gmaxdragon/Jjk-Alarm-Clock-Blare/Docs/COMPACT_REVISION.md

# Compact revision change record

The user authorized retaining the original and rearranging a new smaller version.

- Original: 125 × 110 mm, six switches in a horizontal row.
- Current: 95 × 95 mm, two rows of three full-size switches.
- Top row: SW1 UP, SW3 TIME SET, SW5 SNOOZE.
- Bottom row: SW2 DOWN, SW4 CLOCK SET, SW6 ALARM ON.
- Same electrical schematic, GPIO allocation, component values and logical switch matrix.
- Components moved and tracks rerouted; no uniform scaling. 0.25 mm signal tracks, 0.50 mm power tracks, four 0.7/0.3 mm routing vias, filled bottom GND zone.
- Matching new carrier, front panel and display holder. The normal kit keycaps replace the tall custom extensions in this revision only.
- Decorative source preserved; revised body remeshed on a 1 mm grid before adding functional geometry. Small decorative features can differ.
- The STEP is genuine faceted BREP and the individual print meshes are checked separately. Electronics are reference envelopes.
- New routing, CAD repair/mounts and documentation were produced with substantial AI assistance, disclosed in the README.

The archive includes unchanged original PCB, schematic, project, Gerbers, available original CAD and previous README. `Archive/Original_125x110/PRESERVATION_SHA256.json` records exact source hashes. The original images remain unchanged in Docs/Images.
