gmaxdragon/Jjk-Alarm-Clock-Blare/Docs/REVIEW_REQUEST.md

# JJK Alarm: review request

**Draft only. This message has not been sent and no submission form has been completed.**

Hi,

I'm Vivaan, and this is my JJK Alarm project for BLARE:
https://github.com/gmaxdragon/Jjk-Alarm-Clock-Blare

The original board was too big, so I changed it later with AI's help. The current PCB is 95 x 95 mm, with the six buttons in two rows of three. I kept the original 125 x 110 mm version so you can see the changes.

My friend and I worked on the original PCB and schematic, and I did the original Tinkercad modifications using a MakerWorld shrine model. AI helped with explanations, firmware, the smaller PCB layout and routing, CAD repair and mounting parts, and organizing the files. The README includes my full disclosure and my voice-typed project story.

The current repository has the matching KiCad source files and Gerbers, a complete placed STEP assembly, separate case-part print files, firmware, screenshots, a BOM and validation reports. The electrical checks and firmware compilation pass. The geometry checks use reference component dimensions; I am not claiming the clock has already been printed, assembled, or tested overnight.

I also forgot to click Publish to Stardance for some PCB/schematic timelapses. I selected Public, so I am not sure they were attached. I have not claimed unverified recording hours.

The exact original MakerWorld model link, creator/license and artwork source still need to be recorded in the credits. Please let me know about any required changes and whether the disclosed AI assistance is acceptable for submission. I understand if you return it. Thank you for reviewing it.

Vivaan

## Current file map

- `README.md`: personal story, images, current BOM and disclosures.
- `PCB/`: current 95 mm project, schematic and routed board.
- `Firmware/JJK_Alarm/`: Arduino source and supplied hand-sign image.
- `CAD/JJK_Alarm_Assembly.step`: complete placed assembly, with 50 reimported valid solids and labelled reference electronics.
- `Production/gerbers.zip`: current complete copper/mask/silkscreen/outline/drill package.
- `Production/Case_Parts/`: shrine body, front panel and display retainer.
- `Archive/Original_125x110/`: preserved original design and exports.
- `Docs/SUBMISSION_CHECK.md`: checks and their scope.

Use the current BLARE submission route confirmed by the organizers. This draft does not assert eligibility or acceptance.
