gmaxdragon/Jjk-Alarm-Clock-Blare/Docs/ATTRIBUTION.md

# Source and assistance attribution

- Project owner and original narrated README: Vivaan Goel.
- PCB/schematic hands-on work: Vivaan and a friend, with AI guidance and troubleshooting, as disclosed by the owner.
- Case modifications: Vivaan in Tinkercad. The original shrine geometry includes third-party MakerWorld models.
- MakerWorld model URL, creator, and license: **not supplied in the available project records**. Do not invent a credit or apply a blanket license to that model. Record the exact source and follow its terms before redistribution/submission.
- Screen hand-sign artwork: image supplied by the owner. Its original artist/source and reuse terms have not been established. It is not claimed as original artwork by the project owner.
- Screenshots: original user-uploaded image bytes, recorded in `Images/manifest.json`. No synthetic project views have been substituted.
- `Images/Reference/`: Hack Club kit photo, parts list, and tutorial PCB screenshot supplied by the user; these are reference material, not the user's own PCB.
- Firmware: substantially AI-assisted, using Arduino-ESP32 and Adafruit graphics/display libraries. Library licenses continue to apply to their respective code.
- README editing: dictated by the owner; AI organized/formatted it and corrected technical descriptions. The disclosure is retained, not hidden.
