gmaxdragon/Jjk-Alarm-Clock-Blare/Production/ReviewOnly/READ_FIRST_NOT_APPROVED.md

# BLARE rectangular PCB Gerber preview

**NOT APPROVED FOR FABRICATION.**

Source: PCB/jjkspeakerpcb.kicad_pcb and matching .kicad_sch in this branch.
Generated by KiCad 10 from the rectangular 125 x 110 mm user CAD.
The archive gerbers.zip contains the copper, solder mask, silkscreen, edge cuts,
and plated/non-plated Excellon drill layers.

Native ERC/DRC reports must pass, but physical verification remains outstanding:
TFT module pin order, buzzer 7.6 mm pin pitch/electrical type, XIAO sockets
USB-C/antenna, M3 fasteners, assembly solder quality, power and thermal tests.

Do not order until a human has checked the Gerber preview at the manufacturer.
