gmaxdragon/Jjk-Alarm-Clock-Blare/Archive/README.md

# Historical files

These are superseded T-shaped-design sources and earlier rectangular working exports. They are retained for history, not for fabrication or current dimensions. Use the root PCB, Firmware, CAD and Production folders.
