gmaxdragon/Jjk-Alarm-Clock-Blare/Docs/Images/Compact/PCB_Back.png

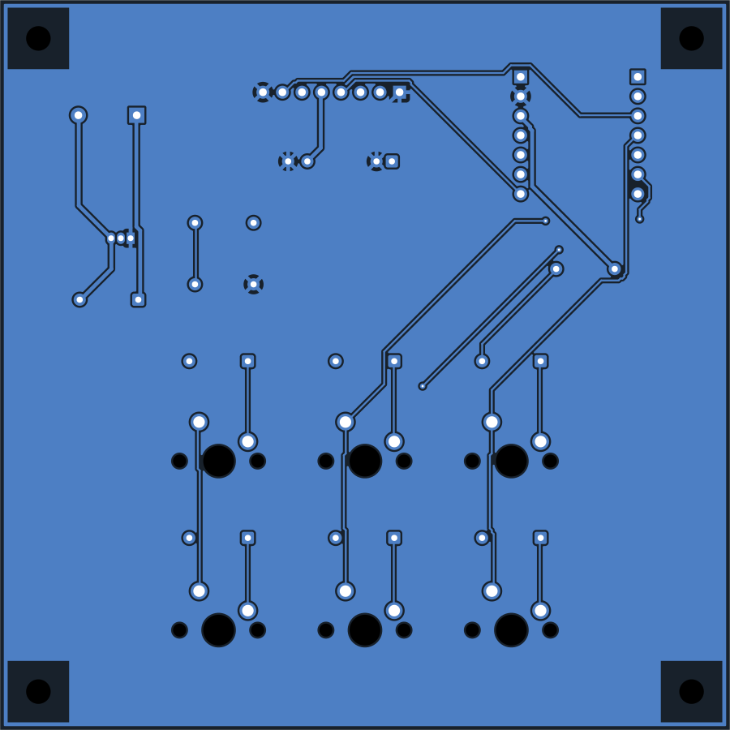
Docs/Images/Compact/PCB_Back.png
