gmaxdragon/Jjk-Alarm-Clock-Blare/Docs/Images/Compact/PCB_Front.png

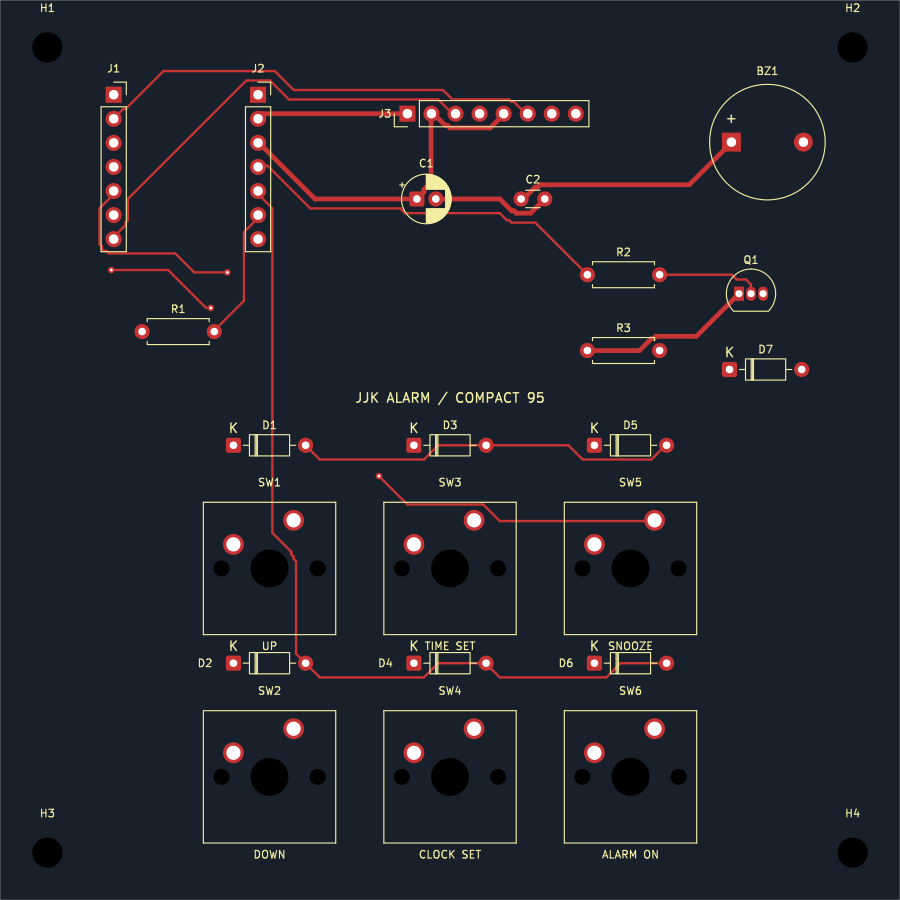
Docs/Images/Compact/PCB_Front.png
