gmaxdragon/Jjk-Alarm-Clock-Blare/Docs/Images/History/Schematic_2026-10-26.png

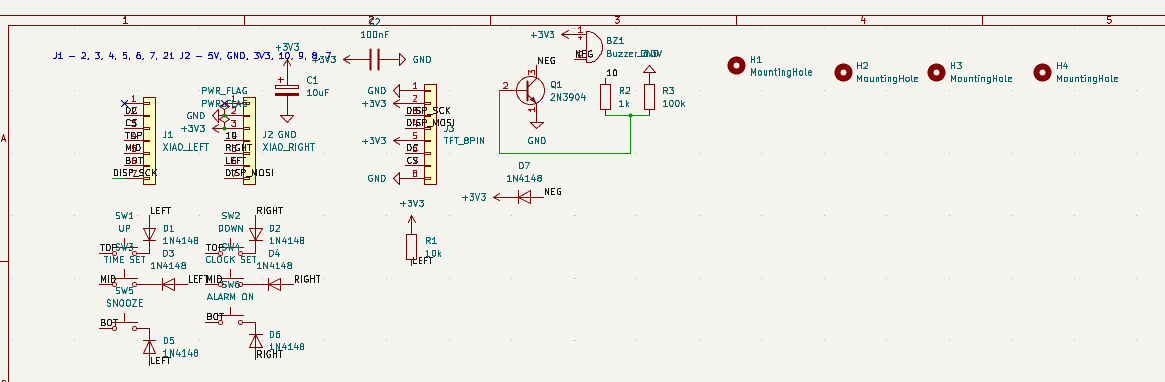
Docs/Images/History/Schematic_2026-10-26.png
