gmaxdragon/Jjk-Alarm-Clock-Blare/Docs/Images/History/Schematic_Earlier.png

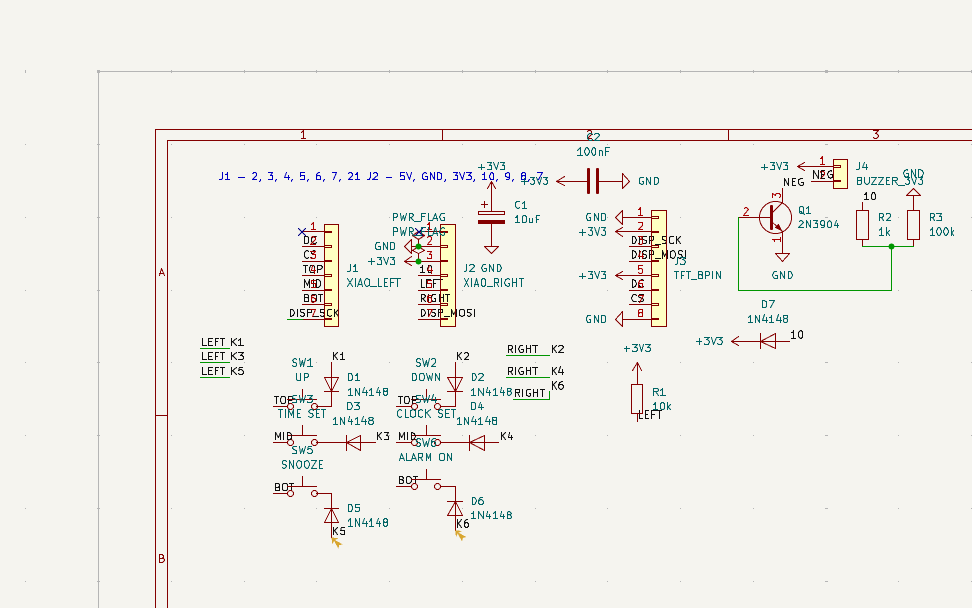
Docs/Images/History/Schematic_Earlier.png
