gmaxdragon/Jjk-Alarm-Clock-Blare/Docs/Images/Reference/BLARE_Example_PCB.png

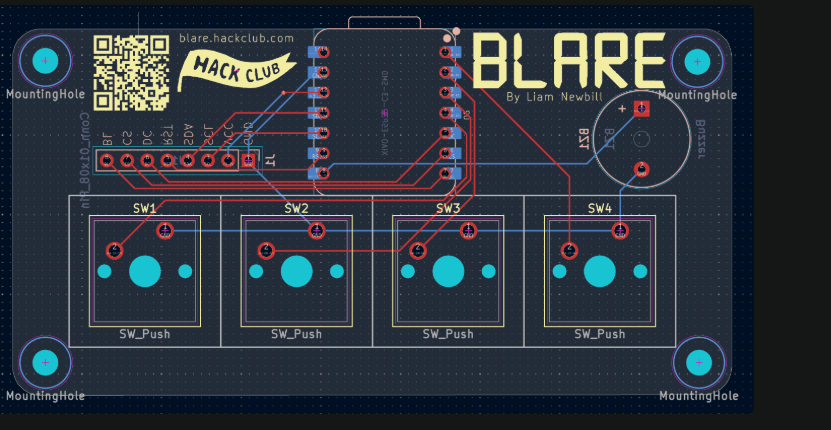
Docs/Images/Reference/BLARE_Example_PCB.png
