gmaxdragon/Jjk-Alarm-Clock-Blare/Docs/Images/Reference/BLARE_Kit.png

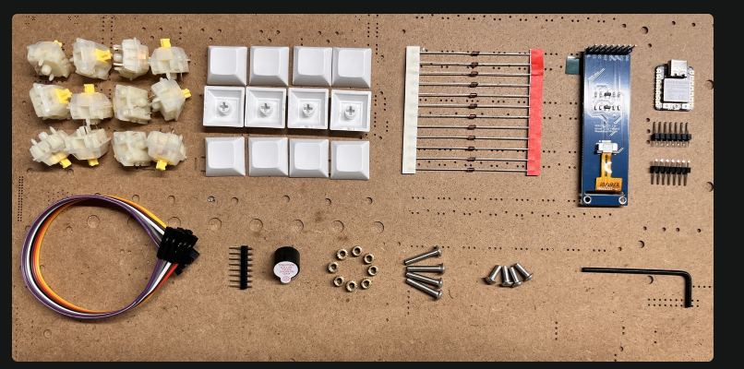
Docs/Images/Reference/BLARE_Kit.png
