gmaxdragon/Jjk-Alarm-Clock-Blare/CAD/Current_References/Component_Positions_mm.csv

Reference | Footprint | X_from_left_mm | Y_from_top_mm | Rotation_deg
BZ1 | Buzzer_12x9.5RM7.6 | 102.475 | 38.775000000000006 | 0.0
C1 | CP_Radial_D5.0mm_P2.00mm | 95.0 | 20.0 | 0.0
C2 | C_Disc_D3.0mm_W1.6mm_P2.50mm | 110.0 | 20.0 | 0.0
D1 | D_DO-35_SOD27_P7.62mm_Horizontal | 19.0 | 59.0 | 0.0
D2 | D_DO-35_SOD27_P7.62mm_Horizontal | 35.0 | 59.0 | 0.0
D3 | D_DO-35_SOD27_P7.62mm_Horizontal | 19.0 | 71.0 | 0.0
D4 | D_DO-35_SOD27_P7.62mm_Horizontal | 35.0 | 71.0 | 0.0
D5 | D_DO-35_SOD27_P7.62mm_Horizontal | 95.0 | 70.0 | 0.0
D6 | D_DO-35_SOD27_P7.62mm_Horizontal | 106.44 | 71.75 | 0.0
D7 | D_DO-35_SOD27_P7.62mm_Horizontal | 99.94 | 61.0 | 0.0
H1 | MountingHole_3.2mm_M3 | 5.0 | 5.0 | 0.0
H2 | MountingHole_3.2mm_M3 | 120.0 | 5.0 | 0.0
H3 | MountingHole_3.2mm_M3 | 5.0 | 65.0 | 0.0
H4 | MountingHole_3.2mm_M3 | 120.0 | 65.0 | 0.0
J1 | PinSocket_1x07_P2.54mm_Vertical | 24.0 | 8.0 | 0.0
J2 | PinSocket_1x07_P2.54mm_Vertical | 39.239999999999995 | 8.0 | 0.0
J3 | PinHeader_1x08_P2.54mm_Vertical | 53.61 | 75.0 | 90.0
Q1 | TO-92_Inline | 97.0 | 51.0 | 0.0
R1 | R_Axial_DIN0207_L6.3mm_D2.5mm_P7.62mm_Horizontal | 30.0 | 42.0 | 0.0
R2 | R_Axial_DIN0207_L6.3mm_D2.5mm_P7.62mm_Horizontal | 82.0 | 46.0 | 0.0
R3 | R_Axial_DIN0207_L6.3mm_D2.5mm_P7.62mm_Horizontal | 83.0 | 59.0 | 0.0
SW1 | SW_Cherry_MX_1.00u_PCB | 17.415000000000006 | 85.91999999999999 | 0.0
SW2 | SW_Cherry_MX_1.00u_PCB | 36.465 | 85.91999999999999 | 0.0
SW3 | SW_Cherry_MX_1.00u_PCB | 55.515 | 85.91999999999999 | 0.0
SW4 | SW_Cherry_MX_1.00u_PCB | 74.565 | 85.91999999999999 | 0.0
SW5 | SW_Cherry_MX_1.00u_PCB | 93.61500000000001 | 85.91999999999999 | 0.0
SW6 | SW_Cherry_MX_1.00u_PCB | 112.66499999999999 | 85.91999999999999 | 0.0
