gmaxdragon/Jjk-Alarm-Clock-Blare/Docs/Images/Reference/BLARE_Parts_List.png

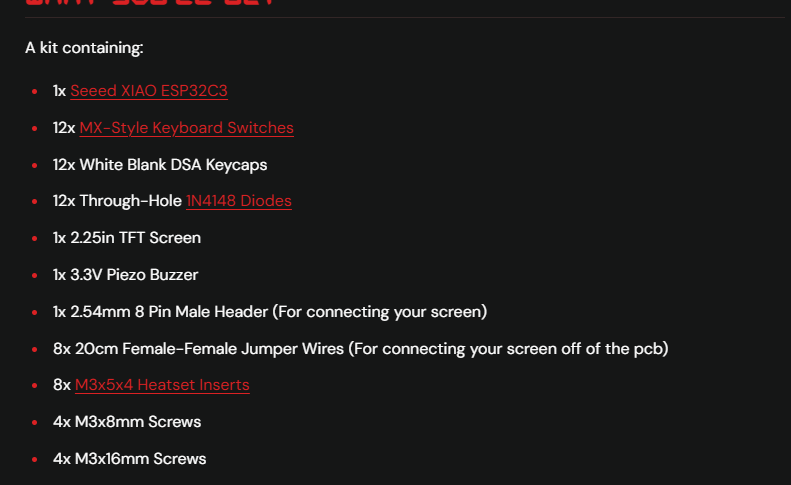
Docs/Images/Reference/BLARE_Parts_List.png
