gmaxdragon/Jjk-Alarm-Clock-Blare/CAD/Current_References/PCB_Finished_Size_Envelope.step

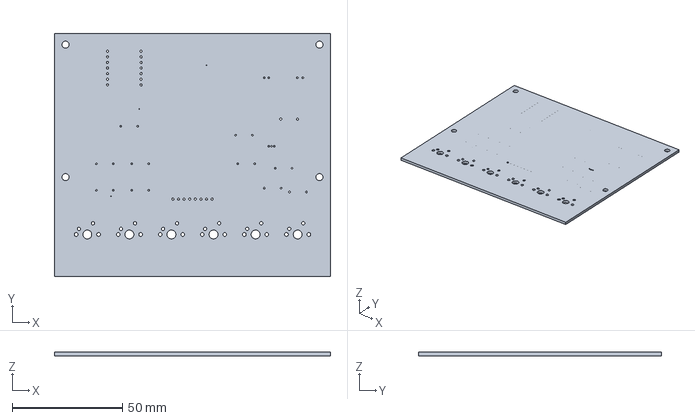
[picture p18: CAD file, 2026-10-28]
CAD/Current_References/PCB_Finished_Size_Envelope.step
125.0 x 110.0 x 1.60 mm
