gmaxdragon/Jjk-Alarm-Clock-Blare/CAD/Owner_Originals/JJK_Alarm_Clock_Enclosure.stl

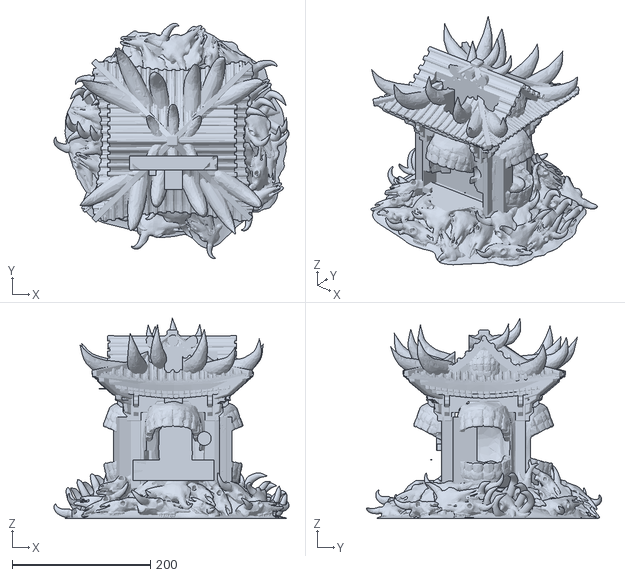
[picture p19: CAD file, 2026-10-28]
CAD/Owner_Originals/JJK_Alarm_Clock_Enclosure.stl
340.0 x 340.0 x 289.8
