gmaxdragon/Jjk-Alarm-Clock-Blare/CAD/Recovered/Keycaps_Recovered.step

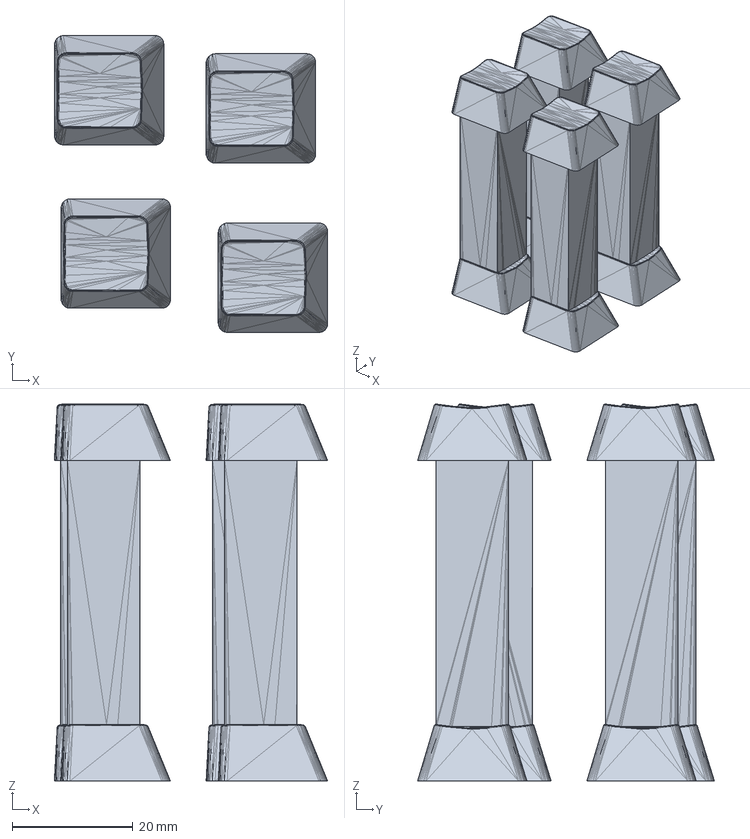
[picture p20: CAD file, 2026-10-28]
CAD/Recovered/Keycaps_Recovered.step
45.2 x 49.1 x 62.4 mm
