gmaxdragon/Jjk-Alarm-Clock-Blare/CAD/Recovered/Original_Keycap_STL/Extended_Keycap_02.stl

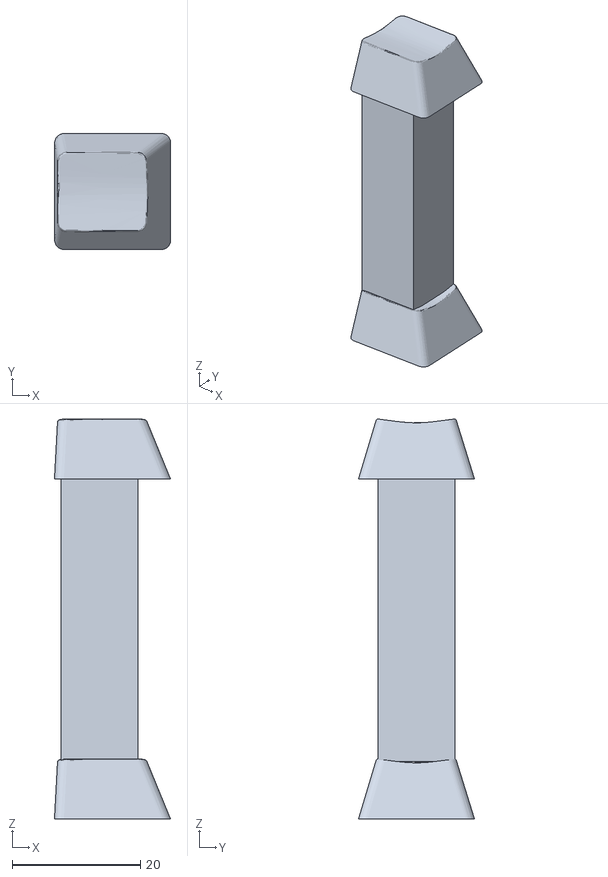
[picture p21: CAD file, 2026-10-28]
CAD/Recovered/Original_Keycap_STL/Extended_Keycap_02.stl
18.1 x 18.1 x 62.4
