gmaxdragon/Jjk-Alarm-Clock-Blare/CAD/Reference/PCB_Finished_Envelope.step

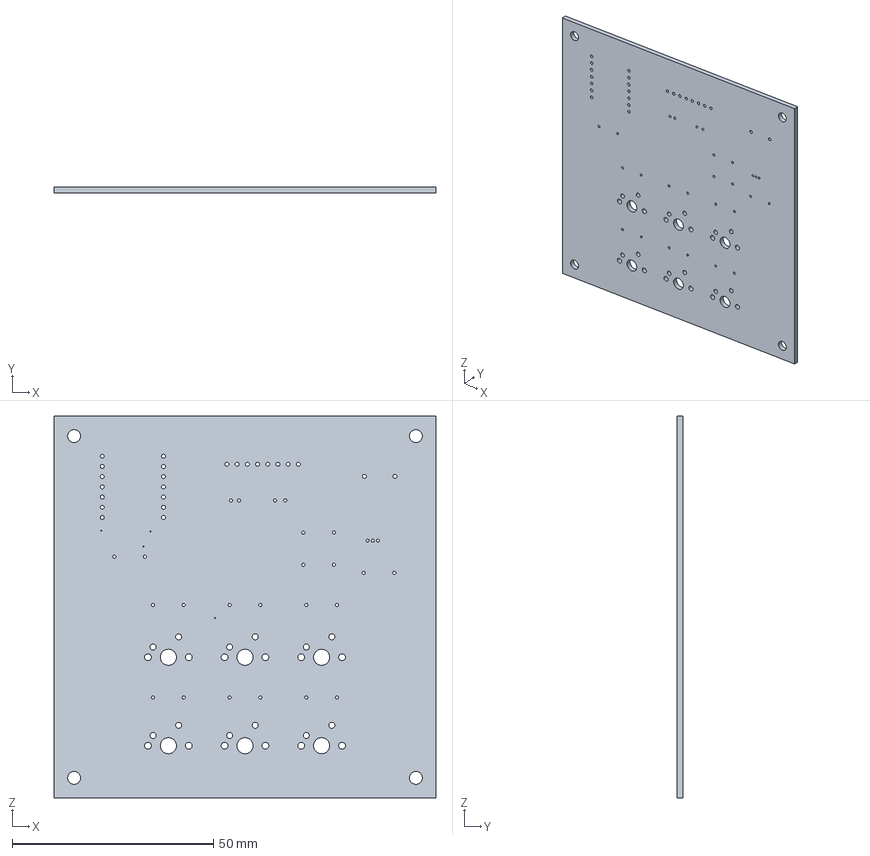
[picture p22: CAD file, 2026-10-28]
CAD/Reference/PCB_Finished_Envelope.step
95.0 x 1.60 x 95.0 mm
