gmaxdragon/Jjk-Alarm-Clock-Blare/Production/Case_Parts/Shrine_Body.stl

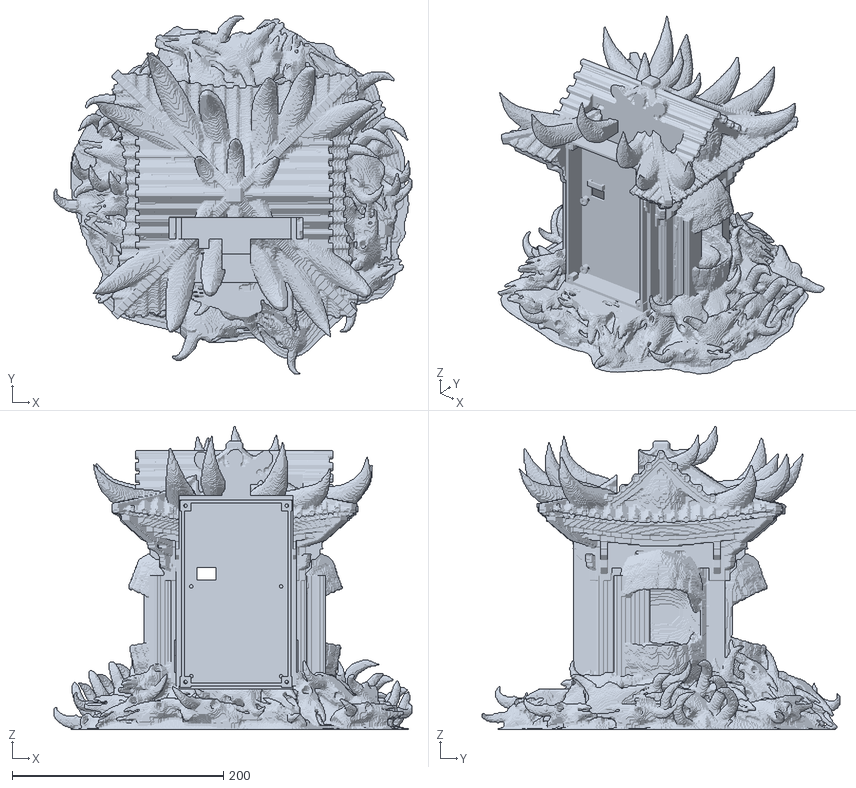
[picture p23: CAD file, 2026-10-28]
Production/Case_Parts/Shrine_Body.stl
339.0 x 339.0 x 287.0
