gmaxdragon/Jjk-Alarm-Clock-Blare/CAD/Current_References/Six_Keycaps.step

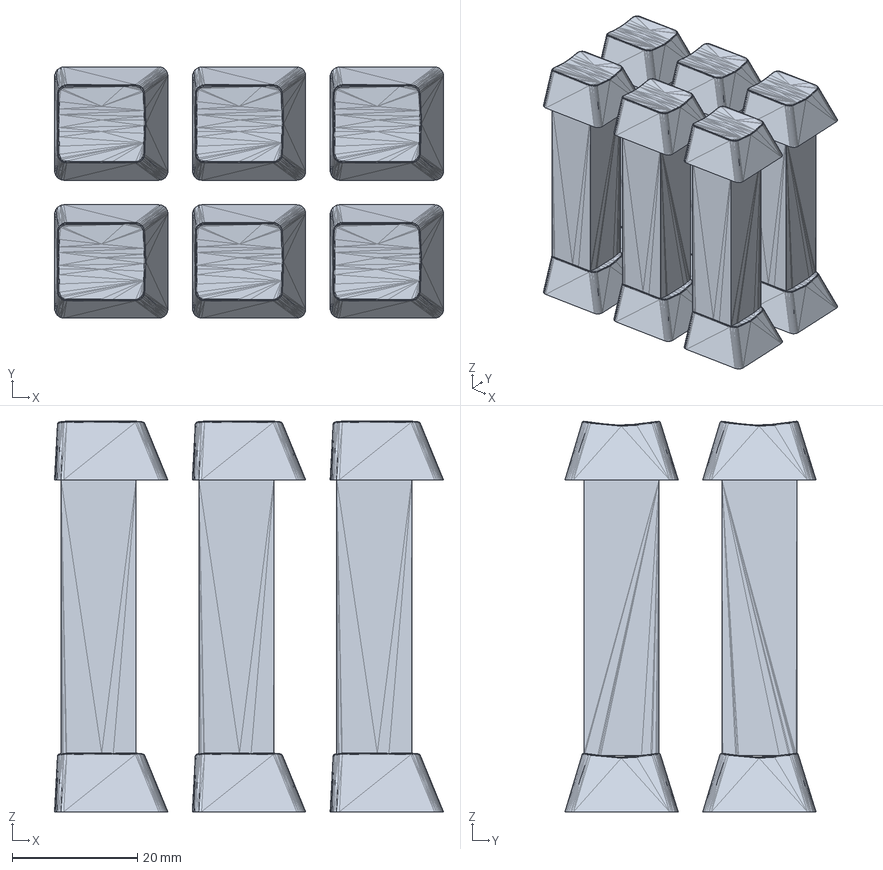
[picture p24: CAD file, 2026-10-28]
CAD/Current_References/Six_Keycaps.step
62.1 x 40.1 x 62.4 mm
