gmaxdragon/Jjk-Alarm-Clock-Blare/CAD/Reference/PCB_Substrate.step

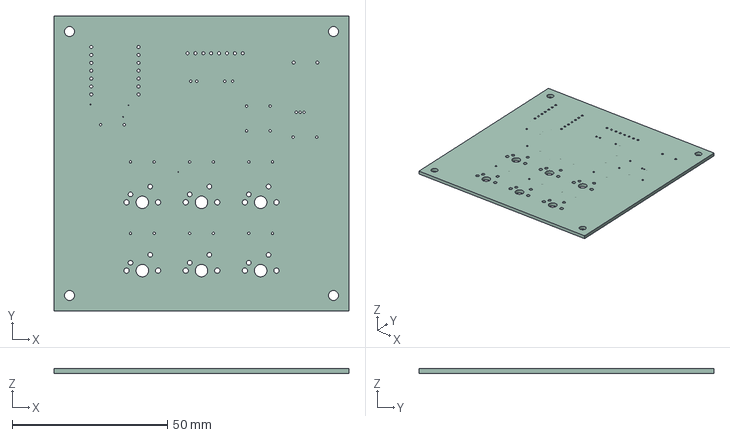
[picture p25: CAD file, 2026-10-28]
CAD/Reference/PCB_Substrate.step
95.0 x 95.0 x 1.51 mm
