gmaxdragon/Jjk-Alarm-Clock-Blare/Production/Case_Parts/Front_Panel.step

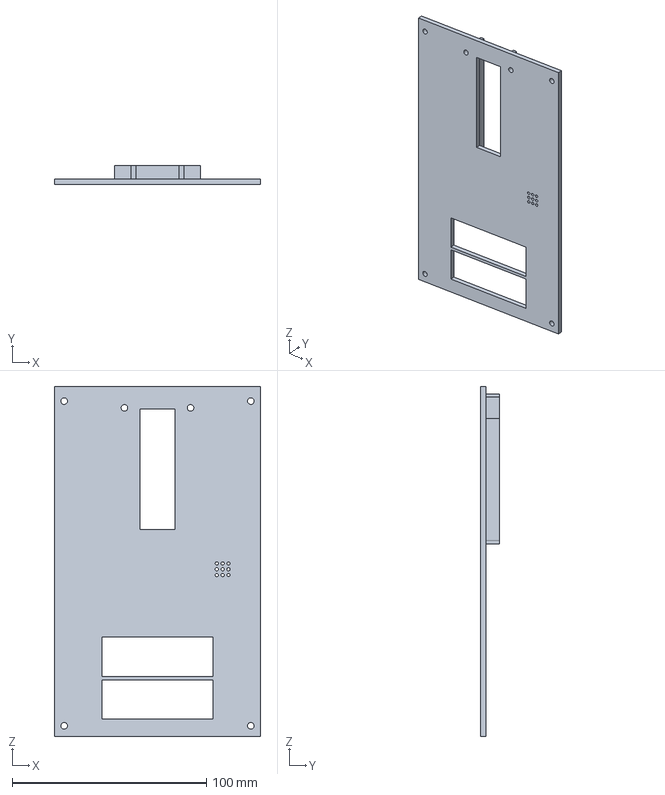
[picture p26: CAD file, 2026-10-28]
Production/Case_Parts/Front_Panel.step
106.0 x 10.0 x 180.0 mm
