gmaxdragon/Jjk-Alarm-Clock-Blare/CAD/Current_References/PCB_Drilled_Body.step

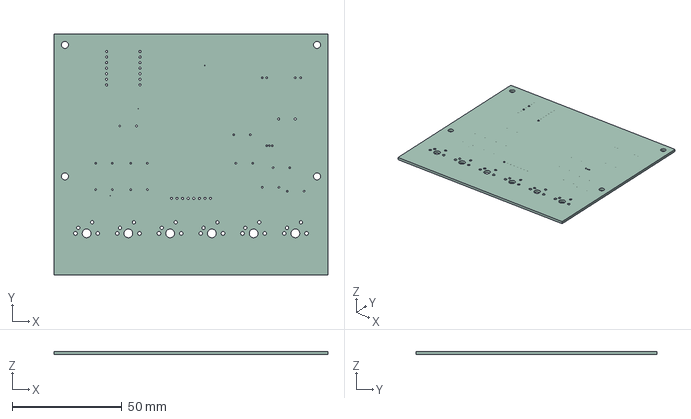
[picture p27: CAD file, 2026-10-28]
CAD/Current_References/PCB_Drilled_Body.step
125.0 x 110.0 x 1.51 mm
