gmaxdragon/Jjk-Alarm-Clock-Blare/Production/Case_Parts/Display_Retainer.step

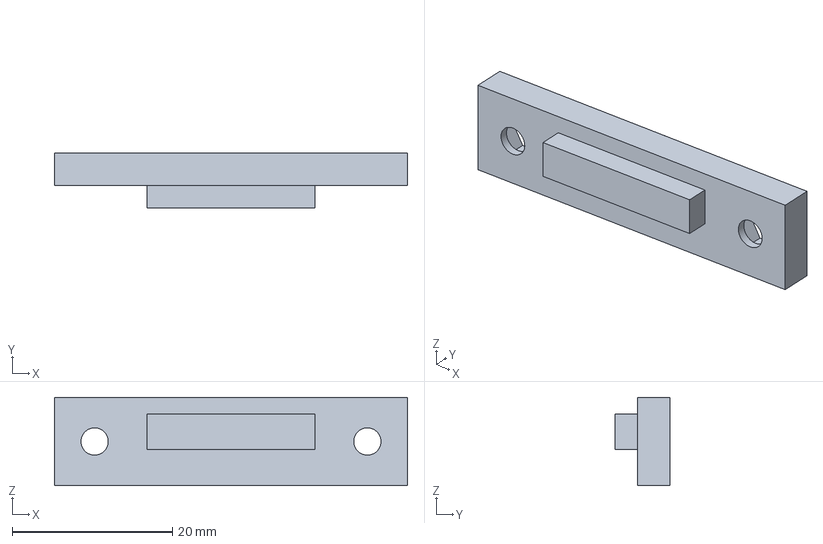
[picture p28: CAD file, 2026-10-28]
Production/Case_Parts/Display_Retainer.step
44.0 x 6.80 x 11.0 mm
