gmaxdragon/Jjk-Alarm-Clock-Blare/(list of files, cad)

Other CAD files:
CAD/JJK_Alarm_Assembly.step
CAD/Recovered/Enclosure_REFERENCE_ONLY.stl
CAD/Recovered/Original_Keycap_STL/Extended_Keycap_03.stl
CAD/Recovered/Original_Keycap_STL/Extended_Keycap_04.stl
CAD/Recovered/Original_Keycap_STL/Extended_Keycap_01.stl
Production/Case_Parts/Keycap_03.step
Production/Case_Parts/Keycap_04.step
Production/Case_Parts/Keycap_06.step
Production/Case_Parts/Keycap_01.step
Production/Case_Parts/Keycap_02.step
Production/Case_Parts/Keycap_05.step
Archive/Original_125x110/CAD/Current_References/PCB_Finished_Size_Envelope.stl
Archive/Original_125x110/CAD/Recovered/Enclosure_REFERENCE_ONLY.stl
Archive/Original_125x110/CAD/Recovered/Original_Keycap_STL/Extended_Keycap_01.stl
Archive/Original_125x110/CAD/Recovered/Original_Keycap_STL/Extended_Keycap_03.stl
Archive/Original_125x110/CAD/Recovered/Original_Keycap_STL/Extended_Keycap_04.stl
Archive/Original_125x110/Production/Case_Parts/Keycap_01.step
Archive/Original_125x110/Production/Case_Parts/Keycap_01.stl
Archive/Original_125x110/Production/Case_Parts/Keycap_02.step
Archive/Original_125x110/Production/Case_Parts/Keycap_02.stl
Archive/Original_125x110/Production/Case_Parts/Keycap_03.step
Archive/Original_125x110/Production/Case_Parts/Keycap_03.stl
Archive/Original_125x110/Production/Case_Parts/Keycap_04.step
Archive/Original_125x110/Production/Case_Parts/Keycap_04.stl
Archive/Original_125x110/Production/Case_Parts/Keycap_05.step
Archive/Original_125x110/Production/Case_Parts/Keycap_05.stl
Archive/Original_125x110/Production/Case_Parts/Keycap_06.step
Archive/Original_125x110/Production/Case_Parts/Keycap_06.stl
CAD/Current_References/PCB_Finished_Size_Envelope.stl
Production/Case_Parts/Display_Retainer.stl
Production/Case_Parts/Front_Panel.stl
Production/Case_Parts/Keycap_01.stl
Production/Case_Parts/Keycap_02.stl
Production/Case_Parts/Keycap_03.stl
Production/Case_Parts/Keycap_04.stl
Production/Case_Parts/Keycap_05.stl
Production/Case_Parts/Keycap_06.stl
