gmaxdragon/Jjk-Alarm-Clock-Blare/Production/Checks/Timer_Tests.txt

JJK timer and stopwatch rollover/pause tests PASS
