gmaxdragon/Jjk-Alarm-Clock-Blare/Production/Checks/Alarm_Tests.txt

JJK AlarmLogic: all 32 behavioral assertions PASS
