gmaxdragon/Jjk-Alarm-Clock-Blare/Docs/Images/History/PCB_2026-10-26.png

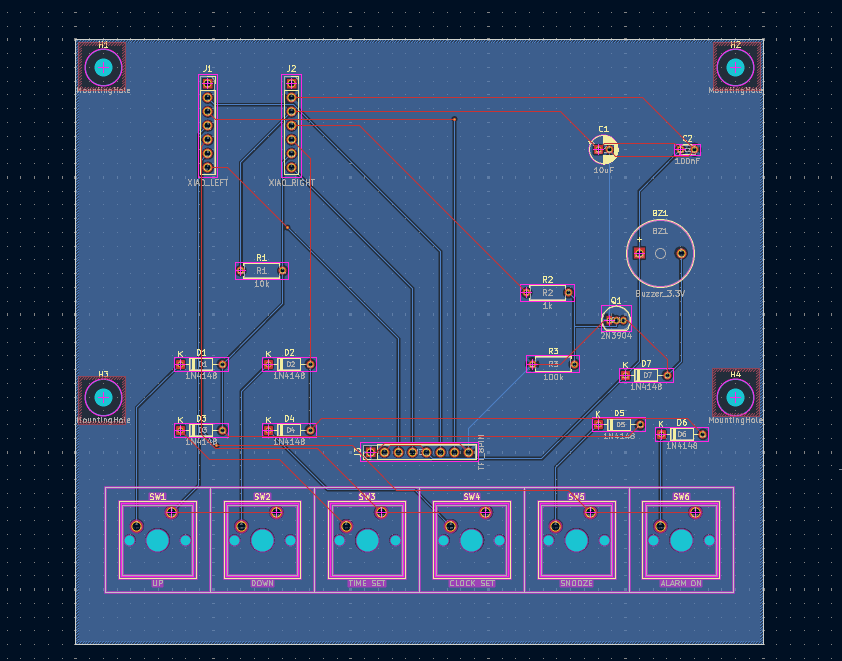
Docs/Images/History/PCB_2026-10-26.png
