gmaxdragon/Jjk-Alarm-Clock-Blare/Docs/Images/History/PCB_Earlier.png

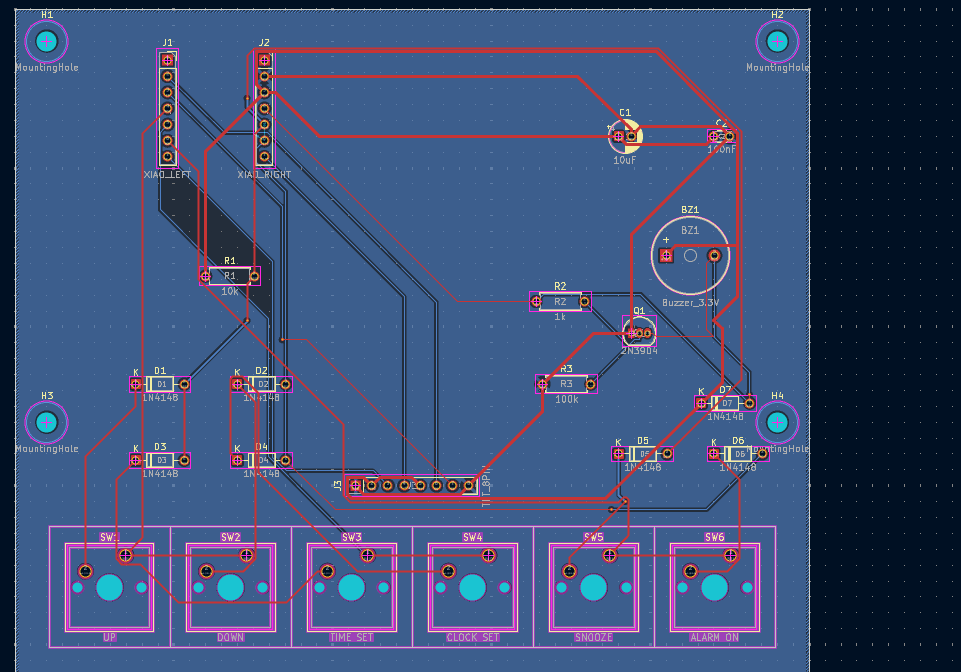
Docs/Images/History/PCB_Earlier.png
