gmaxdragon/Jjk-Alarm-Clock-Blare/Revisions/Compact_95/PCB/jjkspeakerpcb.kicad_pcb

## KiCad design Revisions/Compact_95/PCB/jjkspeakerpcb.kicad_pcb (2026-10-28)

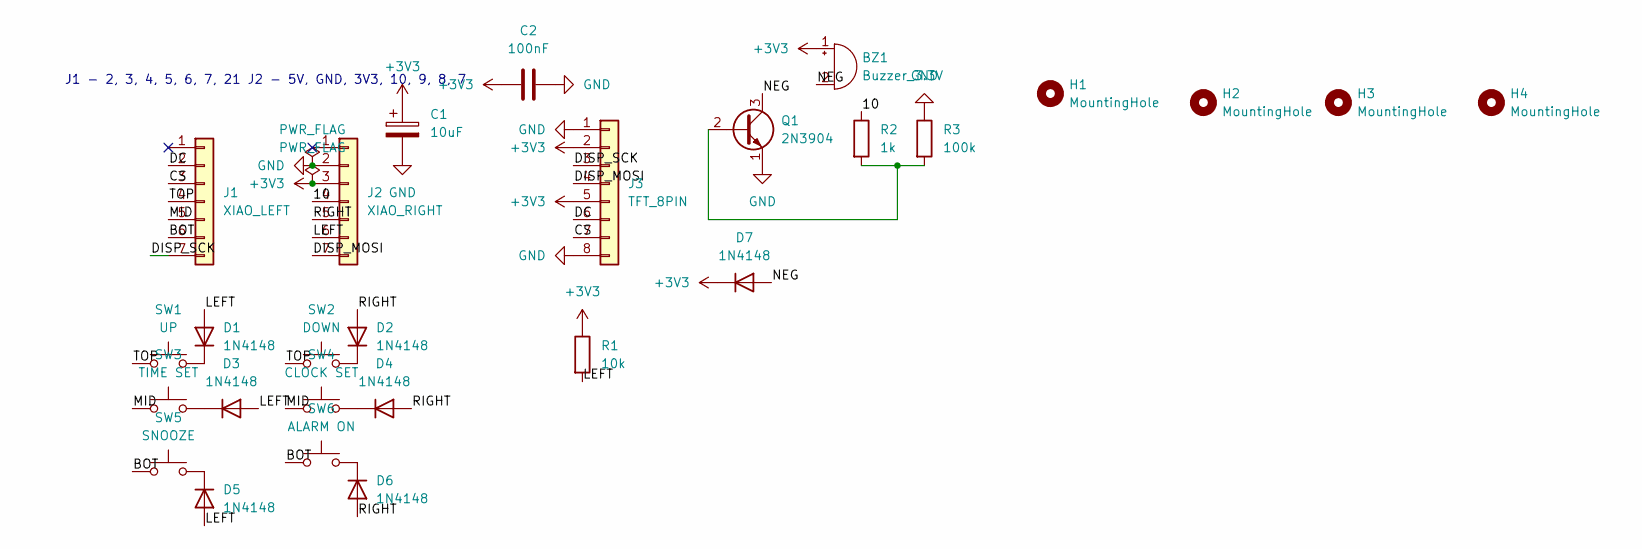
[picture p31: schematic jjkspeakerpcb.kicad_sch]

Parts:
BZ1: Buzzer_3.3V; Buzzer_12x9.5RM7.6
C1: 10uF; CP_Radial_D5.0mm_P2.00mm
C2: 100nF; C_Disc_D3.0mm_W1.6mm_P2.50mm
D1, D2, D3, D4, D5, D6, D7: 1N4148; D_DO-35_SOD27_P7.62mm_Horizontal
H1, H2, H3, H4: MountingHole; MountingHole_3.2mm_M3
J1: XIAO_LEFT; PinSocket_1x07_P2.54mm_Vertical
J2: XIAO_RIGHT; PinSocket_1x07_P2.54mm_Vertical
J3: TFT_8PIN; PinHeader_1x08_P2.54mm_Vertical
Q1: 2N3904; TO-92_Inline
R1: 10k; R_Axial_DIN0207_L6.3mm_D2.5mm_P7.62mm_Horizontal
R2: 1k; R_Axial_DIN0207_L6.3mm_D2.5mm_P7.62mm_Horizontal
R3: 100k; R_Axial_DIN0207_L6.3mm_D2.5mm_P7.62mm_Horizontal
SW1: UP; SW_Cherry_MX_1.00u_PCB
SW2: DOWN; SW_Cherry_MX_1.00u_PCB
SW3: TIME SET; SW_Cherry_MX_1.00u_PCB
SW4: CLOCK SET; SW_Cherry_MX_1.00u_PCB
SW5: SNOOZE; SW_Cherry_MX_1.00u_PCB
SW6: ALARM ON; SW_Cherry_MX_1.00u_PCB

Connections:
+3V3: BZ1.1 (+), C1.1, C2.1, D7.1 (K), J2.3, J3.2, J3.5, R1.1
/10: J2.4, R2.1
/BOT: J1.6, SW5.1, SW6.1
/CS: J1.3, J3.7
/DC: J1.2, J3.6
/DISP_MOSI: J2.7, J3.4
/DISP_SCK: J1.7, J3.3
/LEFT: D1.2 (A), D3.2 (A), D5.2 (A), J2.6, R1.2
/MID: J1.5, SW3.1, SW4.1
/NEG: BZ1.2 (-), D7.2 (A), Q1.3 (C)
/RIGHT: D2.2 (A), D4.2 (A), D6.2 (A), J2.5
/TOP: J1.4, SW1.1, SW2.1
GND: C1.2, C2.2, J2.2, J3.1, J3.8, Q1.1 (E), R3.1
unnamed: D1.1 (K), SW1.2
unnamed: D2.1 (K), SW2.2
unnamed: D3.1 (K), SW3.2
unnamed: D4.1 (K), SW4.2
unnamed: D5.1 (K), SW5.2
unnamed: D6.1 (K), SW6.2
unnamed: Q1.2 (B), R2.2, R3.2

Notes on the sheet:
J1 - 2, 3, 4, 5, 6, 7, 21 J2 - 5V, GND, 3V3, 10, 9, 8, 7

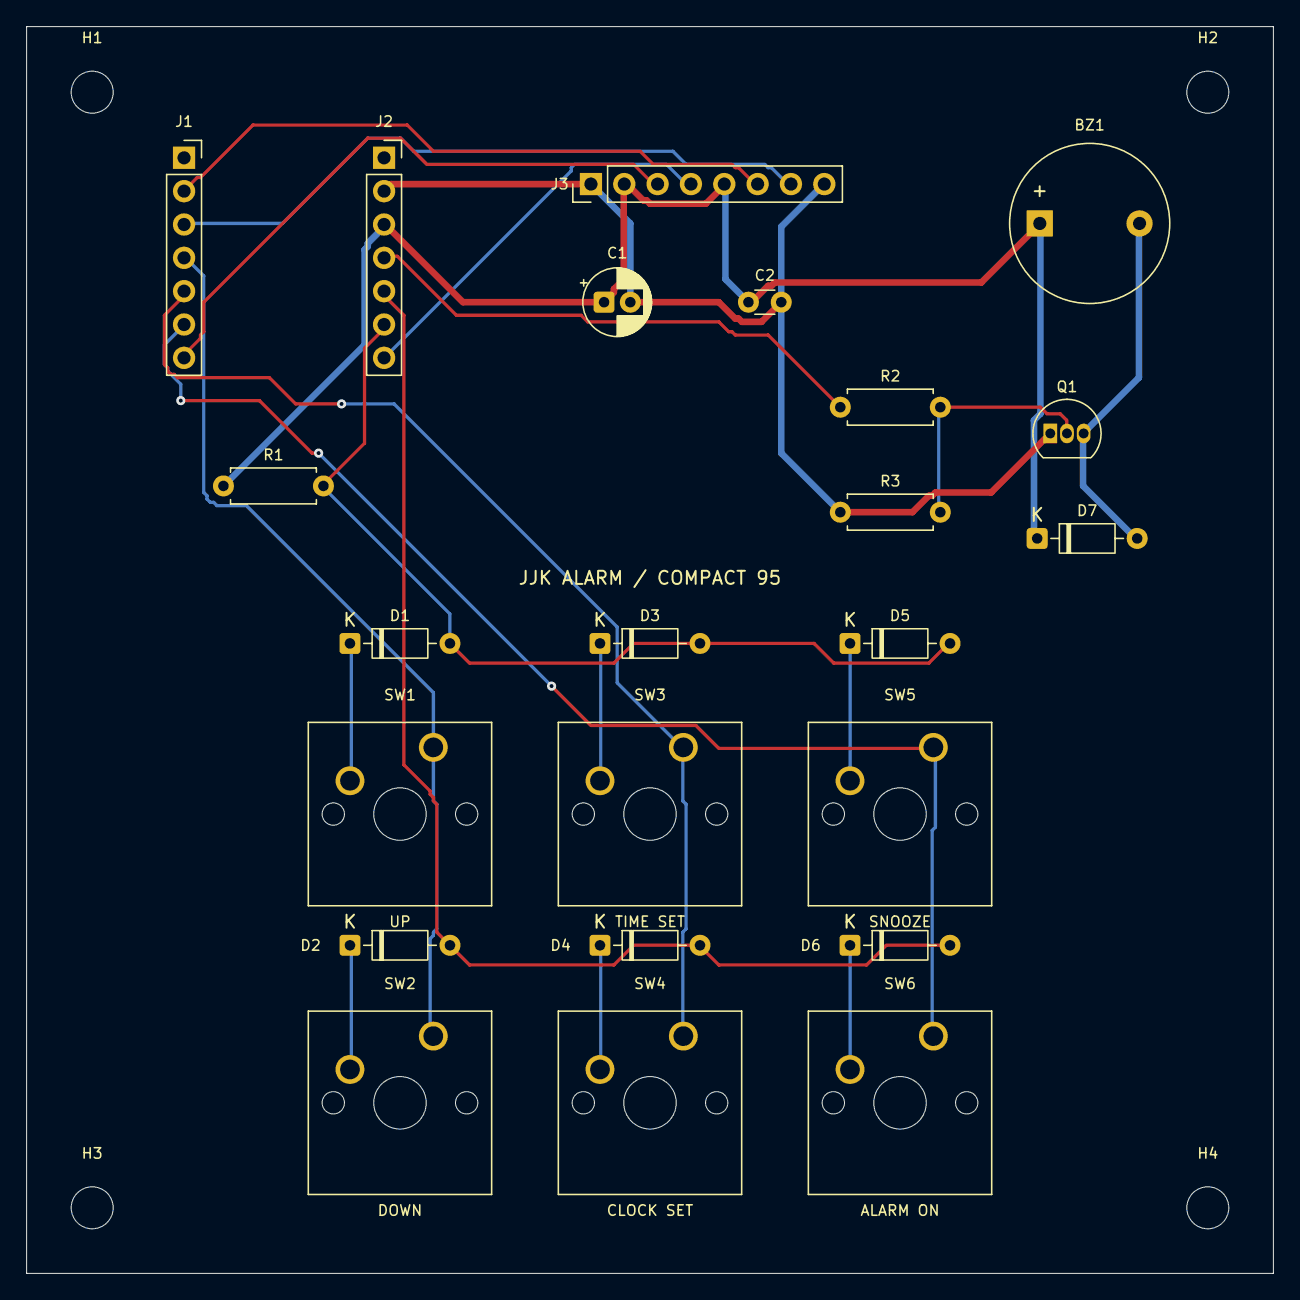
[picture p32: board jjkspeakerpcb.kicad_pcb from above]

Board: 2 copper layers, 95.0 x 95.0 mm, 27 parts (0 on the bottom side), 20 nets.
