gmaxdragon/Jjk-Alarm-Clock-Blare/Firmware/JJK_Alarm/secrets.example.h

#pragma once
// Copy to secrets.h and replace Wi-Fi name/password locally before flashing.
// NEVER put passwords or your portal PIN in a public GitHub repo.
#define JJK_WIFI_SSID ""
#define JJK_WIFI_PASSWORD ""
// Must be >=6 chars. Empty disables phone edit endpoints completely.
#define JJK_PORTAL_PIN ""
// Pacific time and automatic daylight-saving transitions.
#define JJK_TIMEZONE "PST8PDT,M3.2.0/2,M11.1.0/2"
// 0 until actual buzzer type/current/polarity and Q1 driver wiring are verified.
#define JJK_BUZZER_VERIFIED 0
// Set to 1 only after physical wiring, correct polarity and safe supervised testing.
// This flag informs readiness UI; it does NOT magically make hardware safe.
#define JJK_HARDWARE_INSPECTED 0
// 1: print each debounced button event over Serial at 115200; 0: quiet.
#define JJK_DEBUG_KEY_SERIAL 1
