gmaxdragon/Jjk-Alarm-Clock-Blare/(commit log)

2026-10-26 Add GGK Alarm Rev C native PCB/schematic and six-key ESP32 firmware (design hold)
    [jjkspeakerpcb.kicad_pcb, jjkspeakerpcb.kicad_sch]
2026-10-26 Complete GGK Alarm Rev C KiCad libraries, source, safety docs and verification tests
    [BOM_Kit_Only.csv]
2026-10-26 Add native KiCad ERC/DRC and fail-closed engineering CI for GGK Alarm Rev C
2026-10-26 Add real Espressif XIAO ESP32C3 Arduino compilation validation
2026-10-26 Use KiCad 9 native ERC/DRC rather than Ubuntu KiCad 7, which lacks sch erc
2026-10-26 Log complete native KiCad ERC and DRC reports and block release on either failure
2026-10-26 Fix Arduino ESP32 core symbol collision with C alarm() by renaming state variable
2026-10-26 GGK Alarm Rev D: validated KiCad layout, firmware, safety gates and full build guide
    * Add detailed native PCB parser diagnostics to Rev D audit gate
    * Bisect native KiCad file parsing to identify invalid PCB S-expressions
    * Repair malformed GND zone syntax and correct 1N4148 schematic orientation note
    * Rebuild native KiCad from corrected B-side coordinates; remove overlapping holes, align schematic and nets
    * Fix backside fab text mirror and regenerate local KiCad libraries for native ERC/DRC
    * Diagnose remaining XIAO KiCad library mismatch using actual pcbnew geometry
    * Reconstruct XIAO rear module from canonical front footprint with genuine mirrored SMD pads
    * Isolate XIAO library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
    [BOM_Kit_Only.csv, jjkspeakerpcb.kicad_pcb, jjkspeakerpcb.kicad_sch]
2026-10-27 Stage rectangular BLARE KiCad sources, screenshots, and incomplete Gerbers (README held)
    [jjkspeakerpcb.kicad_pcb, jjkspeakerpcb.kicad_sch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]
2026-10-27 Add KiCad 10 preview-only Gerber export and drill validation workflow
2026-10-27 Expose native KiCad ERC/DRC reports when Gerber export is blocked
2026-10-27 Initialize KiCad 10 built-in global symbol and footprint libraries for native Gerber validation
2026-10-27 Generate KiCad 10 review-only Gerber + drill package (fabrication hold)
2026-10-27 Adapt BLARE firmware pin documentation and supervised key diagnostics for rectangular PCB
2026-10-27 Add real XIAO ESP32-C3 firmware compile and pin-safety regression checks
2026-10-27 Document BLARE rectangular PCB firmware flashing and physical verification
2026-10-27 Eliminate ESP32 compiler warnings in BLARE TFT and UI formatting
2026-10-28 Validate current rectangular JJK Alarm sources and renamed firmware
2026-10-28 Publish documentation after registering validation workflow through authorized connector
2026-10-28 Publish JJK Alarm owner narrative, original screenshots, BOM, disclosed assistance and honest submission checklist
    [BOM_Kit_Only.csv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]
2026-10-28 Build and verify recovered CAD exports from the original user attachments
2026-10-28 Document recovered keycap solids and distinguish enclosure reference from complete assembly
2026-10-28 Recover four valid keycap solids and preserve enclosure reference mesh with measured limitations
    [Enclosure_REFERENCE_ONLY.stl, Extended_Keycap_01.stl, Extended_Keycap_02.stl, Extended_Keycap_03.stl, Extended_Keycap_04.stl, Keycaps_Recovered.step]
2026-10-28 Add recovered per-keycap print exports while retaining PCB manufacturing provenance
2026-10-28 Record successful CAD recovery and distinguish review package from full submission compliance
2026-10-28 Package the complete current JJK Alarm repository for organizer review
2026-10-28 Repair JJK Alarm mechanical export workflow and record actual STL contents and PCB dimensions
2026-10-28 Measure routed board from Edge.Cuts centerline instead of including drawing stroke width
2026-10-28 Publish owner PCB revision note, correct dimensional documentation, and validate substrate versus finished-board exports
2026-10-28 Add native PCB dimensions and STEP body plus six validated keycap exports
    [Component_Positions_mm.csv, Drill_Positions_mm.csv, Extended_Keycap_01.stl, Extended_Keycap_02.stl, Extended_Keycap_03.stl, Extended_Keycap_04.stl, Keycap_01.step, Keycap_01.stl]
2026-10-28 Preserve new owner enclosure STL and prepare isolated compact-revision geometry tooling
2026-10-28 Preserve exact new owner shrine enclosure STL without geometry changes
    [JJK_Alarm_Clock_Enclosure.stl]
2026-10-28 Stage 95x95 compact PCB revision and run native KiCad validation without replacing original
2026-10-28 Add separate 95mm compact candidate; original PCB remains unchanged
    [jjkspeakerpcb.kicad_pcb, jjkspeakerpcb.kicad_sch]
2026-10-28 Fix three compact-board reference overlaps and remove expired source-transfer dependency
2026-10-28 Validate compact board with native KiCad and export matching Gerbers and PCB STEP
    [PCB_Substrate.step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]
2026-10-28 Finalize compact revision while preserving original, validate sources and package full CAD assembly
2026-10-28 Validate compact PCB, CAD package and firmware without regenerating original design
2026-10-28 Publish checked 95mm JJK Alarm PCB, full STEP and print parts; retain original 125mm version
    [Component_Positions_mm.csv, Display_Retainer.step, Display_Retainer.stl, Drill_Positions_mm.csv, Enclosure_REFERENCE_ONLY.stl, Extended_Keycap_01.stl, Extended_Keycap_02.stl, Extended_Keycap_03.stl]
2026-10-28 Retire completed import and legacy generation workflows; retain current compact validation
2026-10-28 Clarify compact assembly and physical matrix validation blockers
2026-10-28 Correct validation wording for current Q1-driven compact firmware
    [JJK_Alarm.ino]
2026-10-28 Test all 64 switch combinations against independent PCB diode connectivity
2026-10-28 Record confirmed printer capacity and exhaustive matrix topology checks
2026-10-28 Run independent 64-combination matrix circuit test in validation workflow
